wulffern/rey_tr_sky130a/docs/assets/lsx1.png

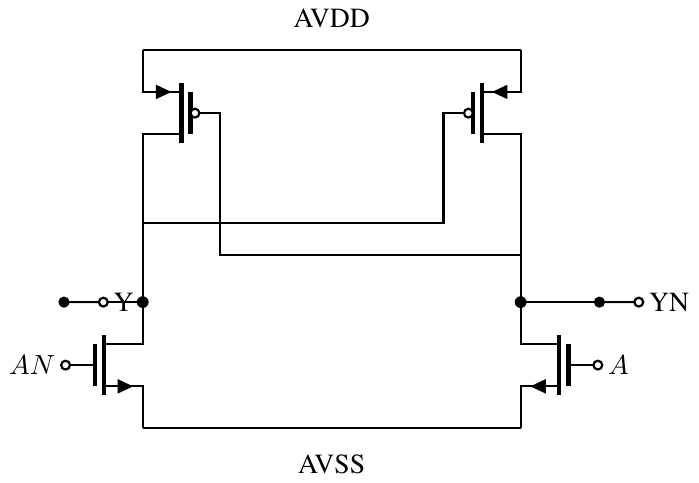
docs/assets/lsx1.png
