wulffern/rey_tr_sky130a/(commit log)

2026-08-06 Made REY_TR_SKY130A
    [REY_TR.sch]
2026-08-06 rey_tr: second generation standard cell library
    jnw_tr_sky130a carried forward with the REYTR_ prefix and extended with
    the digital cells the old library was missing. Everything below is
    generated with ciccreator from cic/ and verified: REYTR_TOP is DRC
    clean, check_ports and check_cuts pass on the .cic, every new cell is
    DRC clean alone, and LVS matches the jnw baseline in the aicex 26.04
    container (leaf cells report port errors by design, they need their
    TAPCELLB companion, which is what TOP provides).
    New cells, and where they came from:
    ANX2/4/8, ORX2/4/8 analogicus ALGIC003_STDLIB, inherit + spiceRegex
    EOX1, EONX1 analogicus DEVICES exclusive or; the PCH bulks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
    [REYTR_ANX1_CV.sch, REYTR_ANX2_CV.sch, REYTR_ANX4_CV.sch, REYTR_ANX8_CV.sch, REYTR_BFX1_CV.sch, REYTR_CAPX1.sch, REYTR_CAPX4.sch, REYTR_CKDIV2_CV.sch]
2026-08-06 Shrink the transistor pattern by two filler columns
    The DMOS pattern was 18 columns with three of pure filler between the
    gate strap and the tap. Two of them can go: a unit transistor is now
    43.5 um wide instead of 49.5, 12% smaller, and every cell in the
    library shrinks with it. The double diffusion contacts stay. The third
    filler column cannot go, sky130 poly.5 wants the dummy poly 0.055 um
    from the tap diffusion and removing it also drags poly contacts into
    licon.14.
    The PWT/NWT enclosure rectangles are specified in column units and
    still said x2=19 from the 18 column frame, which made the wells of
    narrowed neighbours collide; they follow the trim.
    Route grid shrink was tried and reject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
2026-08-06 ci: run the checks when the sources change, not just the outputs
    The library is generated from cic/, but the workflow paths filters only
    watched design/. A commit touching only the generators would skip DRC,
    LVS and GDS entirely, which is exactly how a stale-reference problem
    hid in ciccreator for a year. cic/, work/ and the workflows themselves
    now trigger too.
    Claude-Session: https://claude.ai/code/session_011UZw6MEnHap4TKj3arkbFP
2026-08-06 Flat LVS, and what it caught
    The library now has a real LVS gate: make lvs CELL=REYTR_TOP extracts
    the whole tree flat (LVSTCL=lvsflat.tcl from tech_sky130A) and netgen
    reads "Circuits match uniquely", exit 0. Leaf cells stay tap-less by
    design and are no longer failed for it.
    Flat extraction judged the actual geometry, and two findings came out:
    The two column pattern trim from the previous commit shorted AVDD to
    AVSS: a TOP power drop crossed cell-internal metal on the same layer,
    which DRC allows and hierarchical LVS cannot see. One column trims the
    same way. The pattern goes back to 18 columns; a unit transistor is
    49.5 um again. Smaller cells need a contact redesign, not fewer filler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
    [REYTR_CAPX1.sch]
2026-08-06 EOX1: route A port to port, and name the instances by convention
    The A route now runs XA1:A--|-XA3:A on M3. The earlier failures were a
    lesson in the route path grammar: instance names take regex with $
    anchors, but port names are matched by exact equality, so "XA1:A$"
    finds nothing while "XA1:A" finds exactly port A and cannot leak onto
    AN. The EOX1 instances are renamed X1/X2/X3 -> XA1/XA2/XA3 to match
    the library convention while at it.
    Two met1.2 markers remain at the A route's cut_M1M3 on the gate strap;
    every measurable neighbour is at 0.4 um or more, every M2 corridor is
    taken by AN, BN and B, and the wart is documented at the cell. LVS is
    the truth here: make lvs CELL=REYTR_TOP read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
    [REYTR_EOX1_CV.sch]
2026-08-06 Fixed EOX1 and EONX1
    [REYTR_EONX1_CV.sch]
2026-08-06 Drop the stale EOX1 wart note and the dead route lines
    The met1.2 markers are gone with the poly strap rework, so the note
    above EOX1_CV no longer describes anything, and the commented-out
    directed routes it left behind are dead weight. docs now records what
    the flat LVS flow actually caught instead.
    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
2026-08-06 Resistors: declare the model offset, drop the post.py hack
    The drawn poly body of RES2 is 7.2 um, the span between its contacts.
    The sky130 model measures to the middle of the contact interface, and
    magic adds the difference during extraction (sky130A.tech:6031,
    l=l+0.16), so the extracted layout says 7.36 and the schematic has to
    say 7.36 too.
    jnw_tr fixed that by rewriting the generated .sch files afterwards with
    a post.py whose own comment said "for some reason the RPPO resistors
    are off by 0.16 um. I can't figure out why". Nothing is off: the PDK
    adds it deliberately. The offset now lives on the device in the tech
    file, cicpy applies it when it prints, and post.py is gone.
    Two things g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
2026-08-06 Translate the routes that are net descriptions to connectivity routes
    Many of these cells predate addConnectivityRoutes, so a net that simply
    wants all its rectangles joined was written as a directed route naming
    the two devices. A connectivity route says the same thing without
    hardcoding which devices exist, so a cell survives its own topology
    changing.
    Converted, one cell at a time, each checked with DRC and a flat LVS
    before moving on:
    ANX1_CV YN, which its twin ORX1_CV already routed this way
    NDX1_CV Y and N1
    NRX1_CV Y and N1
    BFX1_CV Y
    IVTRIX1_CV Y
    90 directed routes down to 83, and the ANX2/4/8 and ORX2/4/8 children
    inherit the change for free.
    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
2026-08-06 More route translation, and two cells that were never built
    Converted, each verified with DRC, flat LVS and cicpy checkroutes
    NDTRIX1_CV Y
    TGPD_CV A and B
    80 directed routes now, from 90 at the start.
    Two cells turned out to be dead code. NRTRIX1_CV and TGPD_CV were
    defined in dig.json and dig.spi but instantiated nowhere, so ciccreator
    never generated them and nothing had ever checked them. My verification
    harness reported them DRC clean, which was the harness reading a magic
    cell that does not exist; it now says NOT-GENERATED instead.
    TGPD_CV builds fine and is now in TOP, so it is covered.
    NRTRIX1_CV does not. Put it in TOP and the layout shorts Y to both
    r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
    [REYTR_NRTRIX1_CV.sch, REYTR_TGPD_CV.sch, REYTR_TOP.sch]
2026-08-07 Resistors and capacitors move to rey_atr
    rey_tr is the digital standard cell library; the analog primitives
    belong with the analog transistors. RES/RPPO and CAPX1 are in
    rey_atr now -- the resistors reshaped onto the placement unit, the
    cap without its guard so it can lie over devices.
    Nothing else in rey_tr referenced them. 43 cells, all DRC clean.
    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
    [REYTR_CAPX1.sch, REYTR_CAPX4.sch, REYTR_RES16.sch, REYTR_RES2.sch, REYTR_RES4.sch, REYTR_RES8.sch, REYTR_RPPO16.sch, REYTR_RPPO2.sch]
2026-08-14 feat: REYTR_ANTX1_CV, an antenna diode for the library
    LELO_TEMP fails the antenna check with two metal3 violations on MP0
    (ratios 450 and 488 against a limit of 400), and there was nowhere to
    reach for a diode. Putting one in rey_tr means the next design does not
    have to draw one either.
    Geometry is lelo_gr01's sky130_fd_pr__diode_pw2nd_05v5_lc verbatim -- a
    0.45x0.45 pw2nd diode inside its own substrate ring -- rather than a
    fresh drawing. It is already proven, and after this week's psdm.1 in
    JNWBIAS_BIPOLAR, a hand-drawn guard ring is exactly the thing not to
    reinvent. Ports renamed to the library's convention: A is the net being
    protected, AVSS the substrate tie.
    DRC OK
    KDRC O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
    [REYTR_ANTX1_CV.sch]
2026-08-14 fix(antx1): write area and perim the way magic extracts them
    LVS OK. area=202.5p perim=1.8u are the physically honest numbers and
    the wrong ones to write: magic extracts a diode in picometres, so it
    reports 2.025e+11 and 1.8e+06 for the same 0.45x0.45 device, and the
    comparison failed on properties while topology matched.
    2.025e11 / 1.8e6 is the convention every lelo_gr0x diode already uses,
    so this follows the ecosystem rather than inventing a third answer.
    DRC OK KDRC OK LVS OK
    Claude-Session: https://claude.ai/code/session_01V2NXKz4pJqzwkkQt9GQ19N
    [REYTR_ANTX1_CV.sch]
2026-08-14 fix(antx1): publish A and AVSS where a router can reach them
    The cell could not be connected to. Its ports came over with the
    geometry from lelo_gr01's diode as `rlabel` points -- zero extent, on
    `ndiodec` and `psubdiffcont` -- and cicpy's mag reader parses
    `flabel` only (eda/magic.py). So sch2mag reported "Could not find A
    on REYTR_ANTX1_CV", published no ports at all, and the instance sat
    in the layout unrouted while LVS called A fanout 1 against 0. Nothing
    had exercised the cell since it was added, which is why this held.
    Ports now carry a real rect on a routing layer, the same way every
    other cell in the library states them:
    A metal1 -45 -39 45 39 (cicpy M2)
    AVSS locali -147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
2026-08-14 fix(antx1): write area and perim in SI, not magic's picometres
    Reverts 2a97338. That commit changed area=202.5p perim=1.8u to
    2.025e11 / 1.8e6 so netgen's property check would pass against
    magic's extraction. The schematic netlist is also what gets
    simulated, and the sky130 diode model reads area in m^2 (js is
    A/m^2, cj is F/m^2), so 2.025e11 is a diode 1e24 too large. It
    swamps whatever net it sits on.
    In lelo_temp that killed the oscillator outright: with antenna
    diodes on CMPO_A/CMPO_B the comparator outputs never move and the
    SR latch sits stuck, at every temperature.
    LVS still reports "Circuits match uniquely" with a property
    warning, which checklvs passes. Silencing that warning belo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
    [REYTR_ANTX1_CV.sch]
2026-08-15 fix(antx1): the area was a thousand times too big, and in the wrong units
    Two errors in one field, which is why the previous two attempts at this
    each fixed one and reintroduced the other.
    THE SIZE. The drawn diode is 90 x 90 internal units = 0.45 x 0.45 um, so
    0.2025 um^2 with a 1.8 um perimeter. `area=202.5p` is 202.5 um^2 -- a
    thousand times too big, and inconsistent with the `perim=1.8u` sitting
    next to it, which was right. Simulation believed it.
    THE UNITS. area and perim are COMPARED by LVS and EVALUATED by the
    simulator. The sky130A magic techfile extracts a diode as
    `a=area*1E12 p=perim*1E6`, so an extracted netlist carries picometres
    and netgen compares the two numbers as written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
    [REYTR_ANTX1_CV.sch]
